vkar9898/Multi-Cluster-Control/gerbers/MCC_v1_bom.csv

Designator | Footprint | Quantity | Value | LCSC Part #
C1, C2 | CP_Radial_D10.0mm_P5.00mm | 2 | 470µF 25V
C10, C11, C14, C15, C5, C6, C7, C8, C9 | 0805 | 9 | 100nF | C49678
C16, C17 | 0805 | 2 | 1µF | C28323
C3, C4 | 0805 | 2 | 10µF 25V | C15850
CN1, CN2, CN3 | CONN-TH_10P-P3.81_WJ15EDGRH-3.81-10P-14-00A | 3 | WJ15EDGRH-3.81-10P-14-00A | C48336
CN4 | CONN-TH_4P-P3.81_WJ15EDGRH-3.81-4P-14-00A | 1 | WJ15EDGRH-3.81-4P-14-00A | C26231
D1, D2 | DO-201AD_BD5.3-L8.4-P12.50-D1.4-RD | 2 | SB560 | C139684
D11 | SMA_L4.2-W2.6-LS5.0-RD_1 | 1 | SS14 | C2480
D3, D4 | DO-15_BD3.1-L6.7-P10.70-D0.9-FD | 2 | P6KE15A | C10182
D5, D6, D7, D8, D9 | SOD-123F_L2.7-W1.6-LS3.8-RD | 5 | 1N4148W_C81598 | C81598
F1, F2 | FUSE-SMD_4P-L16.0-W6.7-P3.40 | 2 | 3568 | C5249699
J1, J2 | DC-IN-TH_DC-005-5A-2.0 | 2 | DC-005-5A-2.0 | C381116
J10, J8 | PinHeader_1x02_P2.54mm_Vertical | 2 | Conn_01x02
J11 | DIP-28_W15.24mm_Socket | 1 | Conn_02x14_Counter_Clockwise
J14 | PinHeader_1x03_P2.54mm_Vertical | 1 | Conn_01x03
J15 | TerminalBlock_Phoenix_MKDS-1,5-5-5.08_1x05_P5.08mm_Horizontal | 1 | Screw_Terminal_01x05
J3, J4 | PinSocket_1x19_P2.54mm_Vertical | 2 | Conn_01x19
J5 | PinHeader_1x06_P2.54mm_Vertical | 1 | Conn_01x06
J6 | PinHeader_1x05_P2.54mm_Vertical | 1 | Conn_01x05
J7, J9 | PinHeader_1x07_P2.54mm_Vertical | 2 | Conn_01x07
M5 | PinHeader_1x04_P2.54mm_Vertical | 1 | 5V
M6 | PinHeader_1x04_P2.54mm_Vertical | 1 | 3V6
M7 | PinHeader_1x04_P2.54mm_Vertical | 1 | 24V
Q1, Q2, Q3, Q4, Q5, Q6 | SOT-23-3_L2.9-W1.3-P1.90-LS2.4-BR | 6 | SS8050_C2150 | C2150
Q10, Q11, Q12, Q7, Q8, Q9 | SOT-23-3_L2.9-W1.3-P1.90-LS2.4-BR | 6 | SS8550_C8542 | C8542
Q15, Q16 | SOT-23-3_L2.9-W1.3-P1.90-LS2.4-BR | 2 | MMBT3904-C20526 | C20526
R1, R15, R2, R3, R4, R5, R6, R7, R8 | 0805 | 9 | 1k | C17513
R10, R11, R12, R13, R14, R16, R17, R18, R19, R20, R21, R9 | 0805 | 12 | 2.2k | C17520
R22, R23, R24, R25, R26, R27, R28, R29, R30, R31, R32, R33, R34, R35, R36, R37, R38 | 0805 | 17 | 10k | C17414
U1, U2, U3, U4 | SOIC-20W_7.5x12.8mm_P1.27mm | 4 | TPIC6B595N | C7094
U6, U7, U8 | SOIC-14_3.9x8.7mm_P1.27mm | 3 | 74LS125 | C5962
