vkar9898/Multi-Cluster-Control/(list of files, cad)

Other CAD files:
CAD/Multi-Cluster-Control.step
CAD/Multi-Cluster-Control.FCStd
