vkar9898/Multi-Cluster-Control/images/assembly_side.png

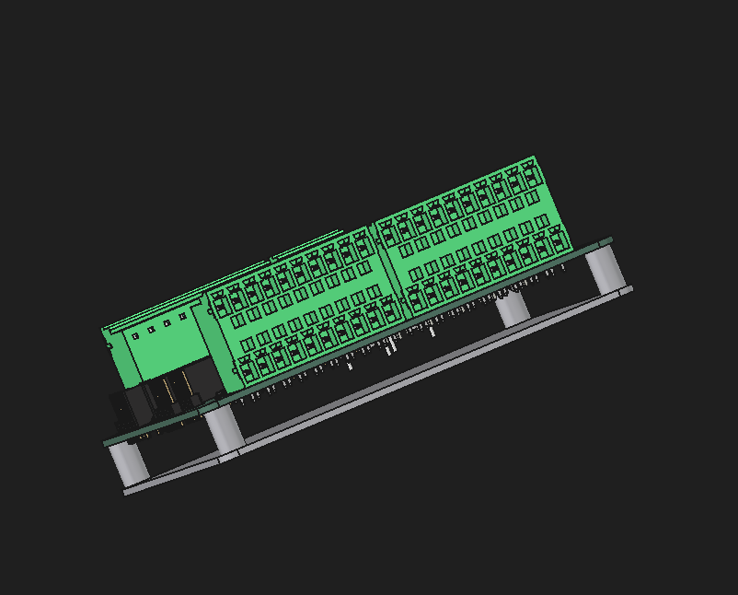
images/assembly_side.png
