vkar9898/Multi-Cluster-Control/images/assembly_top.png

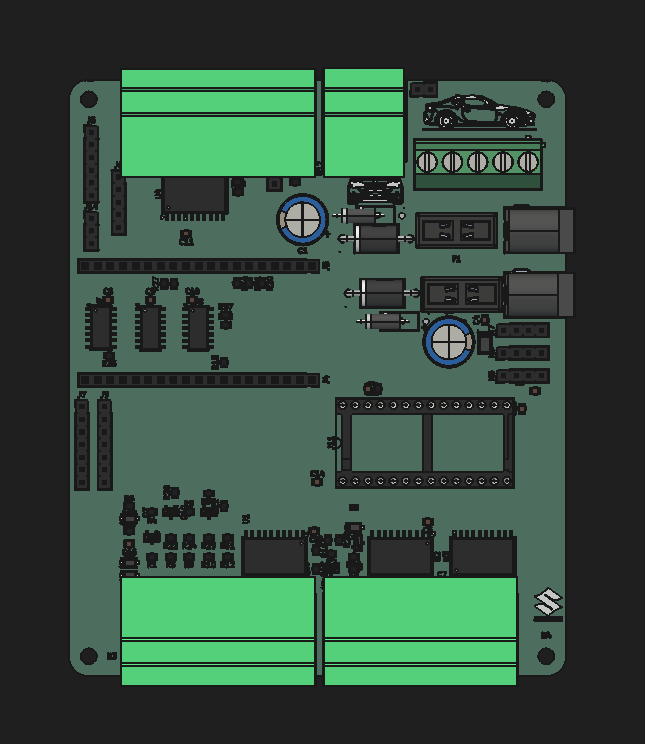
images/assembly_top.png
