vkar9898/Multi-Cluster-Control/JOURNAL.md

---
title: "Multi-Cluster-Control"
github: "https://github.com/vkar9898/Multi-Cluster-Control"
description: "One PCB that controls 7 real car instrument clusters independently, from 1980s analogue gauges requiring AC, to modern CAN-bus dashboards, all running independently from a single ESP32."
created_at: "2026-10-15"
total_time: "9h 36m"
---

# October 23, 2026: Began the schematic
<!-- fabricate:entry 1116 -->

Began making the schematic for the PCB. I plan where each dashboards wire goes before starting, and make the labels along the way. Did all the power stuff (Buck's, fuses, barrel jacks, and a booster). Also wired up the ESP32, as well as the level shifters, and the 4 shift registers. It's going great so far!



Timelapse: https://lapse.hackclub.com/timelapse/IOb_KaSfofoG

**Total time spent: 1h 30m**

# October 26, 2026: Finished the schematic.
<!-- fabricate:entry 1286 -->

Finished making the schematic. Added connector footprints for the 2 CAN modules, the X27 driver, and added all other essential PCB components (transistors, resistors, and capacitors), as well as some headers.



Timelapse: https://lapse.hackclub.com/timelapse/0e1cLzEHD6jz

**Total time spent: 1h**

# October 26, 2026 (entry 2): Started making the PCB
<!-- fabricate:entry 1293 -->

Started routing the PCB. It's a bit difficult due to there being many resistors, diodes, capacitors and such on almost every wire connected to the clusters, but hopefully I can make it all work. So far I haven't started tracing, to ensure fatal mistakes don't get locked in.



Timelapse: https://lapse.hackclub.com/timelapse/egfRrYyQpmj3

**Total time spent: 1h 6m**

# October 27, 2026: Continued placing and routing on PCB
<!-- fabricate:entry 1335 -->

Continued placing and routing on the PCB. Finished connector 1, and the majority of the power stuff. Decided to make the bottom layer a ground pour, which'll ease my life significantly for GND connections. So far it looks a bit cluttered, but there really isn't a much better way of doing it without relying quite heavily on vias.



Timelapse: https://lapse.hackclub.com/timelapse/pn_k8kwHLIcg

**Total time spent: 1h 30m**

# October 28, 2026: More PCB routing
<!-- fabricate:entry 1480 -->

Continued routing the PCB, as usual. Started the CN2 connector a fixed up some tracing issues with CN1 (things like not enough clearance, duplicate vias and such).



Timelapse: https://lapse.hackclub.com/timelapse/eUwztKtLVqtG

**Total time spent: 30m**

# October 29, 2026: Almost finished with the PCB
<!-- fabricate:entry 1528 -->

Almost finished with the PCB. Finished off CN2, and did the bulk of CN3, while ensuring that all lines get proper power with a thick enough trace. This was a little bit of a challenge on CN2, but I managed to make it work via the long route along the right of the PCB. It's starting to come together now, and I am becoming increasingly happier as I notice that there are less components to place.



Timelapse: https://lapse.hackclub.com/timelapse/g2Dk5GwVGELh

**Total time spent: 1h 30m**

# October 30, 2026: Finished the PCB
<!-- fabricate:entry 1643 -->

Finally completed the PCB in a long 2.5 hour session. Did CN3, CN4, and the U6-8 modules sitting underneath the ESP32, making sure no traces sit under the antenna. Also added some cool art of the W126 front, Suzuki logo (car is too niche to have any royalty free blueprints), GT86, and the F10. It looks great! The hardest part of this is definitely grounding everything, there were so many islands left that needed grounds...



Timelapse: https://lapse.hackclub.com/timelapse/QanxuUaG0hgY

**Total time spent: 2h 30m**
