vkar9898/Multi-Cluster-Control/KiCAD/Multi-Cluster-Control.kicad_pcb

## KiCad design KiCAD/Multi-Cluster-Control.kicad_pcb (2026-11-02)

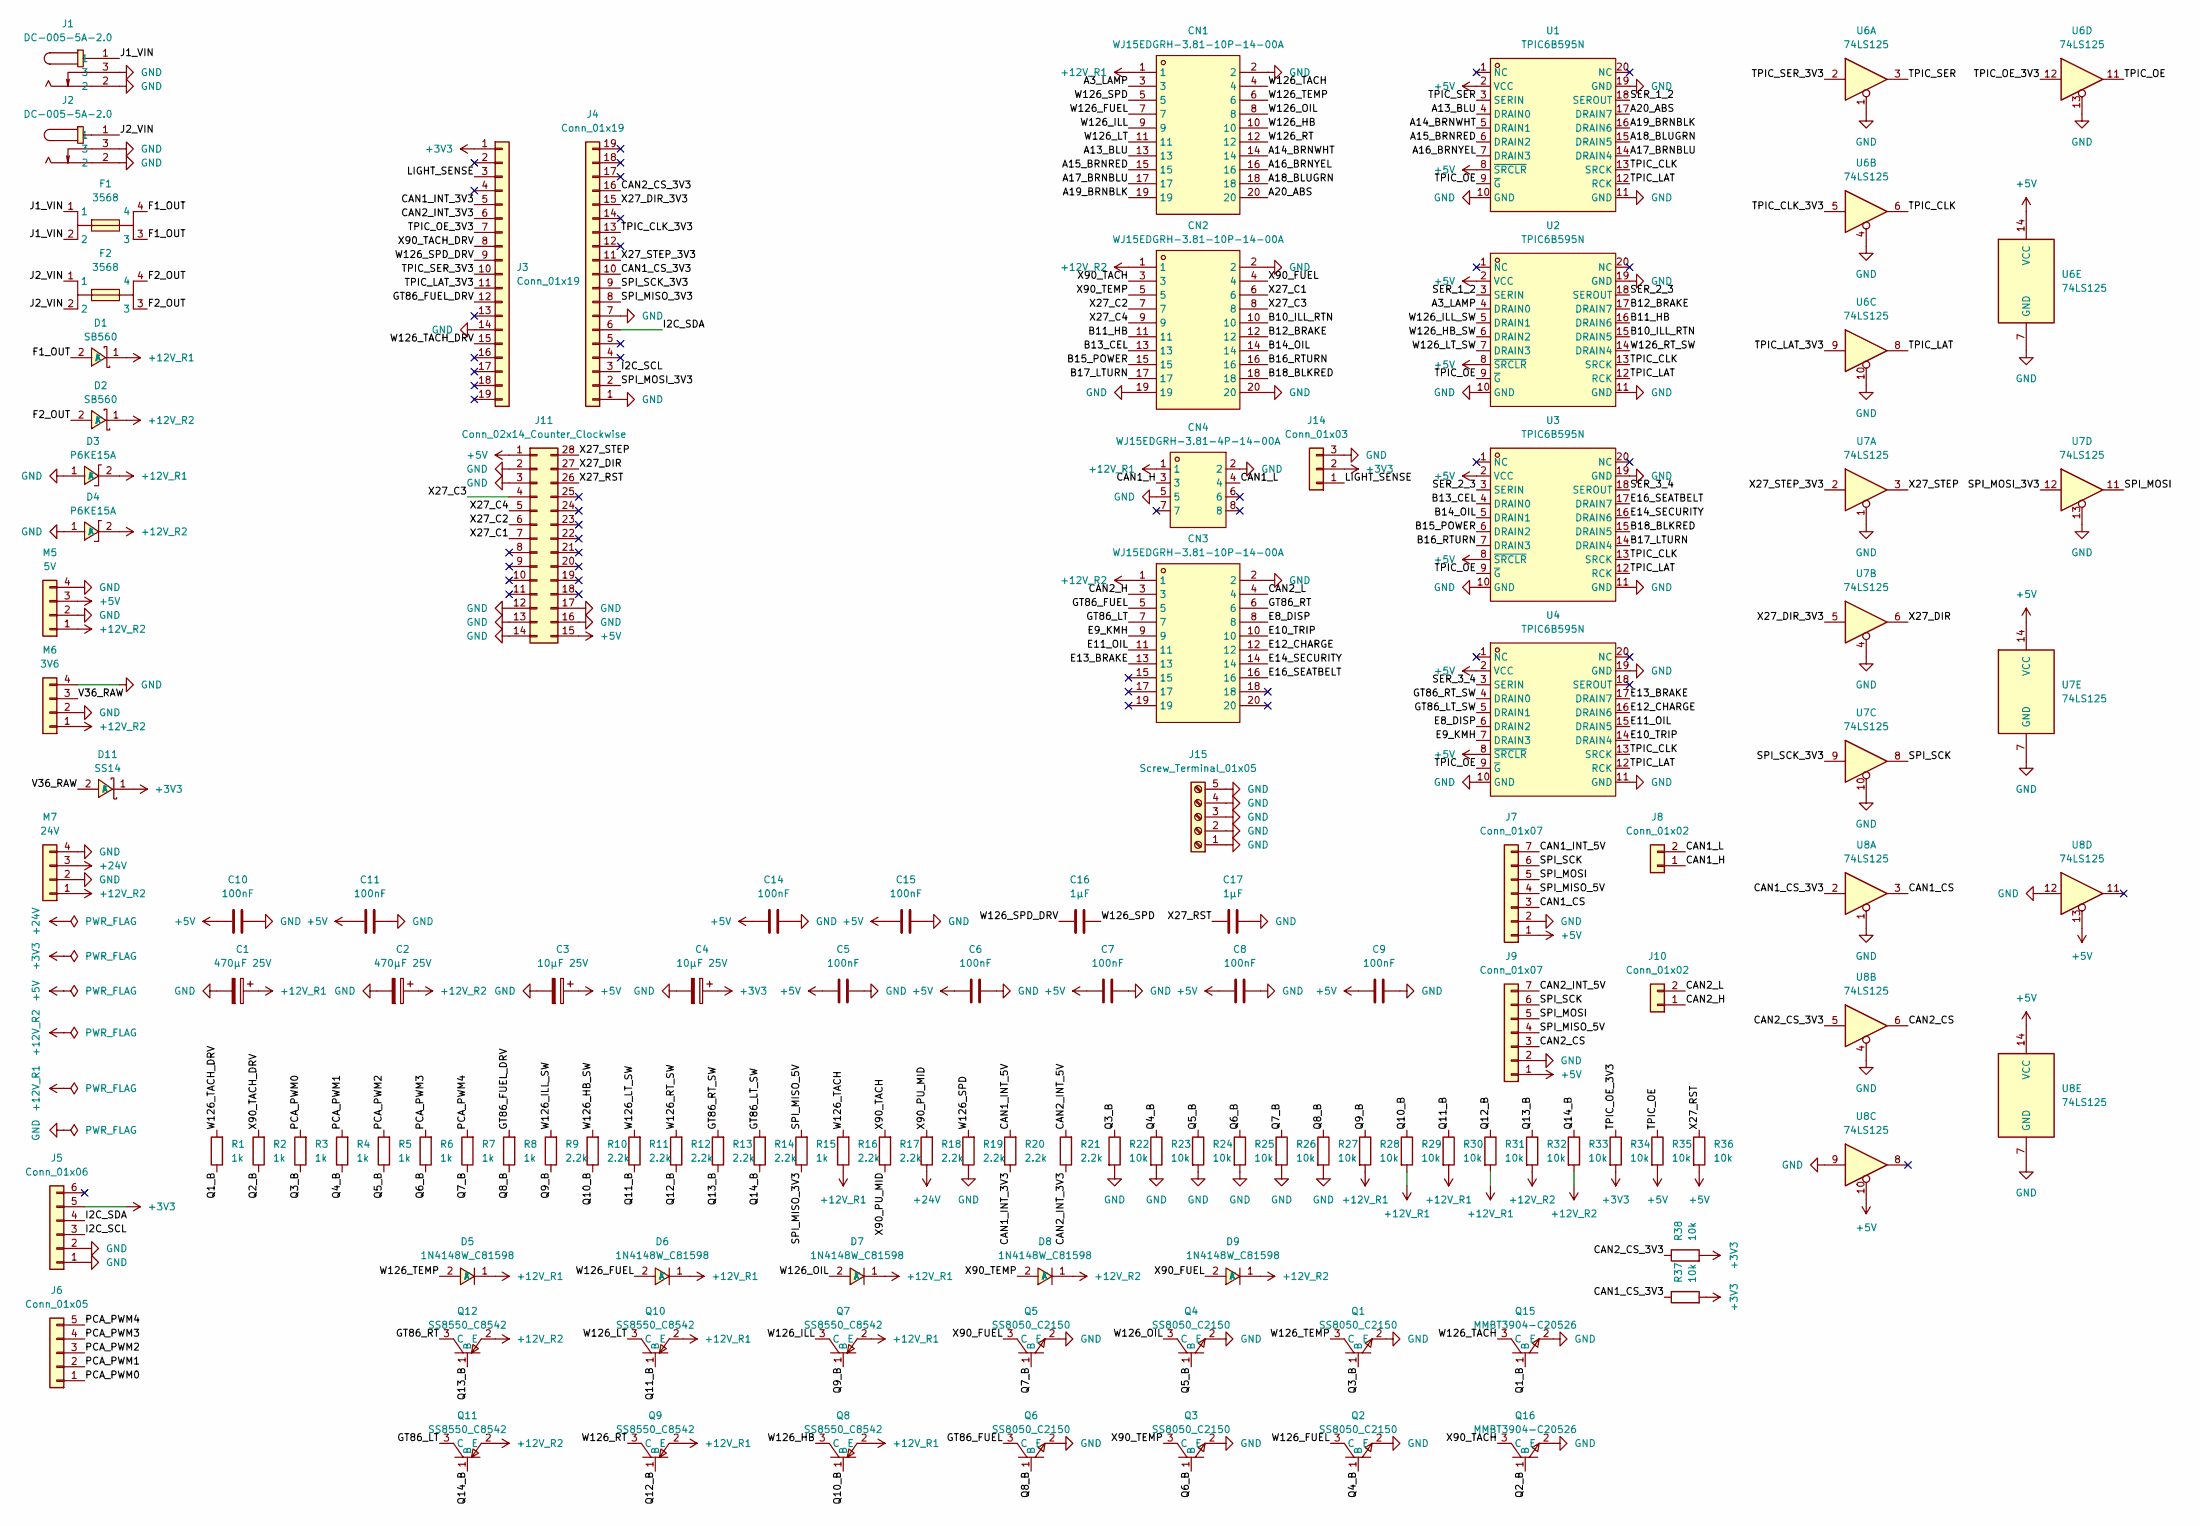
[picture p6: schematic Multi-Cluster-Control.kicad_sch]

Parts:
C1, C2: 470µF 25V; CP_Radial_D10.0mm_P5.00mm
C3, C4: 10µF 25V; C_0805_2012Metric; LCSC Part C15850
C5, C6, C7, C8, C9, C10, C11, C14, C15: 100nF; C_0805_2012Metric; LCSC Part C49678
C16, C17: 1µF; C_0805_2012Metric; LCSC Part C28323
CN1, CN2, CN3: WJ15EDGRH-3.81-10P-14-00A; CONN-TH_10P-P3.81_WJ15EDGRH-3.81-10P-14-00A; MPN WJ15EDGRH-3.81-10P-14-00A; LCSC Part C48336
CN4: WJ15EDGRH-3.81-4P-14-00A; CONN-TH_4P-P3.81_WJ15EDGRH-3.81-4P-14-00A; MPN WJ15EDGRH-3.81-04P-14-00A; LCSC Part C26231
D1, D2: SB560; DO-201AD_BD5.3-L8.4-P12.50-D1.4-RD; MPN SB560; LCSC Part C139684
D3, D4: P6KE15A; DO-15_BD3.1-L6.7-P10.70-D0.9-FD; MPN P6KE15A; LCSC Part C10182
D5, D6, D7, D8, D9: 1N4148W_C81598; SOD-123F_L2.7-W1.6-LS3.8-RD; MPN 1N4148W; LCSC Part C81598
D11: SS14; SMA_L4.2-W2.6-LS5.0-RD_1; MPN SS14; LCSC Part C2480
F1, F2: 3568; FUSE-SMD_4P-L16.0-W6.7-P3.40; MPN 3568; LCSC Part C5249699
J1, J2: DC-005-5A-2.0; DC-IN-TH_DC-005-5A-2.0; MPN DC-005-5A-2.0; LCSC Part C381116
J3, J4: Conn_01x19; PinSocket_1x19_P2.54mm_Vertical
J5: Conn_01x06; PinHeader_1x06_P2.54mm_Vertical
J6: Conn_01x05; PinHeader_1x05_P2.54mm_Vertical
J7, J9: Conn_01x07; PinHeader_1x07_P2.54mm_Vertical
J8, J10: Conn_01x02; PinHeader_1x02_P2.54mm_Vertical
J11: Conn_02x14_Counter_Clockwise; DIP-28_W15.24mm_Socket
J14: Conn_01x03; PinHeader_1x03_P2.54mm_Vertical
J15: Screw_Terminal_01x05; TerminalBlock_Phoenix_MKDS-1,5-5-5.08_1x05_P5.08mm_Horizont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
M5: 5V; PinHeader_1x04_P2.54mm_Vertical
M6: 3V6; PinHeader_1x04_P2.54mm_Vertical
M7: 24V; PinHeader_1x04_P2.54mm_Vertical
Q1, Q2, Q3, Q4, Q5, Q6: SS8050_C2150; SOT-23-3_L2.9-W1.3-P1.90-LS2.4-BR; MPN SS8050(RANGE:200-350); LCSC Part C2150
Q7, Q8, Q9, Q10, Q11, Q12: SS8550_C8542; SOT-23-3_L2.9-W1.3-P1.90-LS2.4-BR; MPN SS8550 Y2(RANGE:200-350); LCSC Part C8542
Q15, Q16: MMBT3904-C20526; SOT-23-3_L2.9-W1.3-P1.90-LS2.4-BR; MPN MMBT3904(RANGE:100-300); LCSC Part C20526
R1, R2, R3, R4, R5, R6, R7, R8, R15: 1k; R_0805_2012Metric; LCSC Part C17513
R9, R10, R11, R12, R13, R14, R16, R17, R18, R19, R20, R21: 2.2k; R_0805_2012Metric; LCSC Part C17520
R22, R23, R24, R25, R26, R27, R28, R29, R30, R31, R32, R33, R34, R35, R36, R37, R38: 10k; R_0805_2012Metric; LCSC Part C17414
U1, U2, U3, U4: TPIC6B595N; SOIC-20W_7.5x12.8mm_P1.27mm; MPN TPIC6B595N; LCSC Part C7094
U6, U7, U8: 74LS125; SOIC-14_3.9x8.7mm_P1.27mm; LCSC Part C5962

Connections:
+3V3: C4.1, D11.1 (K), J3.1, J5.5, J14.2, R34.2, R37.2, R38.2
+5V: C3.1, C5.2, C6.2, C7.2, C8.2, C9.2, C10.2, C11.2, C14.2, C15.2, J7.1, J9.1, J11.1, J11.15, M5.3, R35.2, R36.2, U1.2 (VCC), U1.8 (~SRCLR), U2.2 (VCC), U2.8 (~SRCLR), U3.2 (VCC), U3.8 (~SRCLR), U4.2 (VCC), U4.8 (~SRCLR), U6.14 (VCC), U7.14 (VCC), U8.10, U8.13, U8.14 (VCC)
+12V_R1: C1.1, CN1.1, CN4.1, D1.1 (K), D3.2 (K), D5.1 (K), D6.1 (K), D7.1 (K), Q7.2 (E), Q8.2 (E), Q9.2 (E), Q10.2 (E), R16.1, R28.2, R29.2, R30.2, R31.2
+12V_R2: C2.1, CN2.1, CN3.1, D2.1 (K), D4.2 (K), D8.1 (K), D9.1 (K), M5.1, M6.1, M7.1, Q11.2 (E), Q12.2 (E), R32.2, R33.2
+24V: M7.3, R18.1
/A3_LAMP: CN1.3, U2.4 (DRAIN0)
/A13_BLU: CN1.13, U1.4 (DRAIN0)
/A14_BRNWHT: CN1.14, U1.5 (DRAIN1)
/A15_BRNRED: CN1.15, U1.6 (DRAIN2)
/A16_BRNYEL: CN1.16, U1.7 (DRAIN3)
/A17_BRNBLU: CN1.17, U1.14 (DRAIN4)
/A18_BLUGRN: CN1.18, U1.15 (DRAIN5)
/A19_BRNBLK: CN1.19, U1.16 (DRAIN6)
/A20_ABS: CN1.20, U1.17 (DRAIN7)
/B10_ILL_RTN: CN2.10, U2.15 (DRAIN5)
/B11_HB: CN2.11, U2.16 (DRAIN6)
/B12_BRAKE: CN2.12, U2.17 (DRAIN7)
/B13_CEL: CN2.13, U3.4 (DRAIN0)
/B14_OIL: CN2.14, U3.5 (DRAIN1)
/B15_POWER: CN2.15, U3.6 (DRAIN2)
/B16_RTURN: CN2.16, U3.7 (DRAIN3)
/B17_LTURN: CN2.17, U3.14 (DRAIN4)
/B18_BLKRED: CN2.18, U3.15 (DRAIN5)
/CAN1_CS: J7.3, U8.3
/CAN1_CS_3V3: J4.10, R37.1, U8.2
/CAN1_H: CN4.3, J8.1
/CAN1_INT_3V3: J3.5, R20.1
/CAN1_INT_5V: J7.7, R20.2
/CAN1_L: CN4.4, J8.2
/CAN2_CS: J9.3, U8.6
/CAN2_CS_3V3: J4.16, R38.1, U8.5
/CAN2_H: CN3.3, J10.1
/CAN2_INT_3V3: J3.6, R21.1
/CAN2_INT_5V: J9.7, R21.2
/CAN2_L: CN3.4, J10.2
/E8_DISP: CN3.8, U4.6 (DRAIN2)
/E9_KMH: CN3.9, U4.7 (DRAIN3)
/E10_TRIP: CN3.10, U4.14 (DRAIN4)
/E11_OIL: CN3.11, U4.15 (DRAIN5)
/E12_CHARGE: CN3.12, U4.16 (DRAIN6)
/E13_BRAKE: CN3.13, U4.17 (DRAIN7)
/E14_SECURITY: CN3.14, U3.16 (DRAIN6)
/E16_SEATBELT: CN3.16, U3.17 (DRAIN7)
/F1_OUT: D1.2 (A), F1.3, F1.4
/F2_OUT: D2.2 (A), F2.3, F2.4
/GT86_FUEL: CN3.5, Q6.3 (C)
/GT86_FUEL_DRV: J3.12, R8.2
/GT86_LT: CN3.7, Q11.3 (C)
/GT86_LT_SW: R14.2, U4.5 (DRAIN1)
/GT86_RT: CN3.6, Q12.3 (C)
/GT86_RT_SW: R13.2, U4.4 (DRAIN0)
/I2C_SCL: J4.3, J5.3
/I2C_SDA: J4.6, J5.4
/J1_VIN: F1.1, F1.2, J1.1
/J2_VIN: F2.1, F2.2, J2.1
/LIGHT_SENSE: J3.3, J14.1
/PCA_PWM0: J6.1, R3.2
/PCA_PWM1: J6.2, R4.2
/PCA_PWM2: J6.3, R5.2
/PCA_PWM3: J6.4, R6.2
/PCA_PWM4: J6.5, R7.2
/Q1_B: Q15.1 (B), R1.1
/Q2_B: Q16.1 (B), R2.1
/Q3_B: Q1.1 (B), R3.1, R22.1
/Q4_B: Q2.1 (B), R4.1, R23.1
/Q5_B: Q4.1 (B), R5.1, R24.1
/Q6_B: Q3.1 (B), R6.1, R25.1
/Q7_B: Q5.1 (B), R7.1, R26.1
/Q8_B: Q6.1 (B), R8.1, R27.1
/Q9_B: Q7.1 (B), R9.1, R28.1
/Q10_B: Q8.1 (B), R10.1, R29.1
/Q11_B: Q10.1 (B), R11.1, R30.1
/Q12_B: Q9.1 (B), R12.1, R31.1
/Q13_B: Q12.1 (B), R13.1, R32.1
/Q14_B: Q11.1 (B), R14.1, R33.1
/SER_1_2: U1.18 (SEROUT), U2.3 (SERIN)
/SER_2_3: U2.18 (SEROUT), U3.3 (SERIN)
/SER_3_4: U3.18 (SEROUT), U4.3 (SERIN)
/SPI_MISO_3V3: J4.8, R15.1
/SPI_MISO_5V: J7.4, J9.4, R15.2
/SPI_MOSI: J7.5, J9.5, U7.11
/SPI_MOSI_3V3: J4.2, U7.12
/SPI_SCK: J7.6, J9.6, U7.8
/SPI_SCK_3V3: J4.9, U7.9
/TPIC_CLK: U1.13 (SRCK), U2.13 (SRCK), U3.13 (SRCK), U4.13 (SRCK), U6.6
/TPIC_CLK_3V3: J4.13, U6.5
/TPIC_LAT: U1.12 (RCK), U2.12 (RCK), U3.12 (RCK), U4.12 (RCK), U6.8
/TPIC_LAT_3V3: J3.11, U6.9
/TPIC_OE: R35.1, U1.9 (~G), U2.9 (~G), U3.9 (~G), U4.9 (~G), U6.11
/TPIC_OE_3V3: J3.7, R34.1, U6.12
/TPIC_SER: U1.3 (SERIN), U6.3
/TPIC_SER_3V3: J3.10, U6.2
/V36_RAW: D11.2 (A), M6.3
/W126_FUEL: CN1.7, D6.2 (A), Q2.3 (C)
/W126_HB: CN1.10, Q8.3 (C)
/W126_HB_SW: R10.2, U2.6 (DRAIN2)
/W126_ILL: CN1.9, Q7.3 (C)
/W126_ILL_SW: R9.2, U2.5 (DRAIN1)
/W126_LT: CN1.11, Q10.3 (C)
/W126_LT_SW: R11.2, U2.7 (DRAIN3)
/W126_OIL: CN1.8, D7.2 (A), Q4.3 (C)
/W126_RT: CN1.12, Q9.3 (C)
/W126_RT_SW: R12.2, U2.14 (DRAIN4)
/W126_SPD: C16.1, CN1.5, R19.2
/W126_SPD_DRV: C16.2, J3.9
/W126_TACH: CN1.4, Q15.3 (C), R16.2
/W126_TACH_DRV: J3.15, R1.2
/W126_TEMP: CN1.6, D5.2 (A), Q1.3 (C)
/X27_C1: CN2.6, J11.7
/X27_C2: CN2.7, J11.6
/X27_C3: CN2.8, J11.4
/X27_C4: CN2.9, J11.5
/X27_DIR: J11.27, U7.6
/X27_DIR_3V3: J4.15, U7.5
/X27_RST: C17.2, J11.26, R36.1
/X27_STEP: J11.28, U7.3
/X27_STEP_3V3: J4.11, U7.2
/X90_FUEL: CN2.4, D9.2 (A), Q5.3 (C)
/X90_PU_MID: R17.1, R18.2
/X90_TACH: CN2.3, Q16.3 (C), R17.2
/X90_TACH_DRV: J3.8, R2.2
/X90_TEMP: CN2.5, D8.2 (A), Q3.3 (C)
GND: C1.2, C2.2, C3.2, C4.2, C5.1, C6.1, C7.1, C8.1, C9.1, C10.1, C11.1, C14.1, C15.1, C17.1, CN1.2, CN2.2, CN2.19, CN2.20, CN3.2, CN4.2, CN4.5, D3.1 (A), D4.1 (A), J1.2, J1.3, J2.2, J2.3, J3.14, J4.1, J4.7, J5.1, J5.2, J7.2, J9.2, J11.2, J11.3, J11.12, J11.13, J11.14, J11.16, J11.17, J14.3, J15.1, J15.2, J15.3, J15.4, J15.5, M5.2, M5.4, M6.2, M6.4, M7.2, M7.4, Q1.2 (E), Q2.2 (E), Q3.2 (E), Q4.2 (E), Q5.2 (E), Q6.2 (E), Q15.2 (E), Q16.2 (E), R19.1, R22.2, R23.2, R24.2, R25.2, R26.2, R27.2, U1.10 (GND), U1.11 (GND), U1.19 (GND), U2.10 (GND), U2.11 (GND), U2.19 (GND), U3.10 (GND), U3.11 (GND), U3.19 (GND), U4.10 (GND), U4.11 (GND), U4.19 (GND), U6.1, U6.4, U6.7 (GND), U6.10, U6.13, U7.1, U7.4, U7.7 (GND), U7.10, U7.13, U8.1, U8.4, U8.7 (GND), U8.9, U8.12

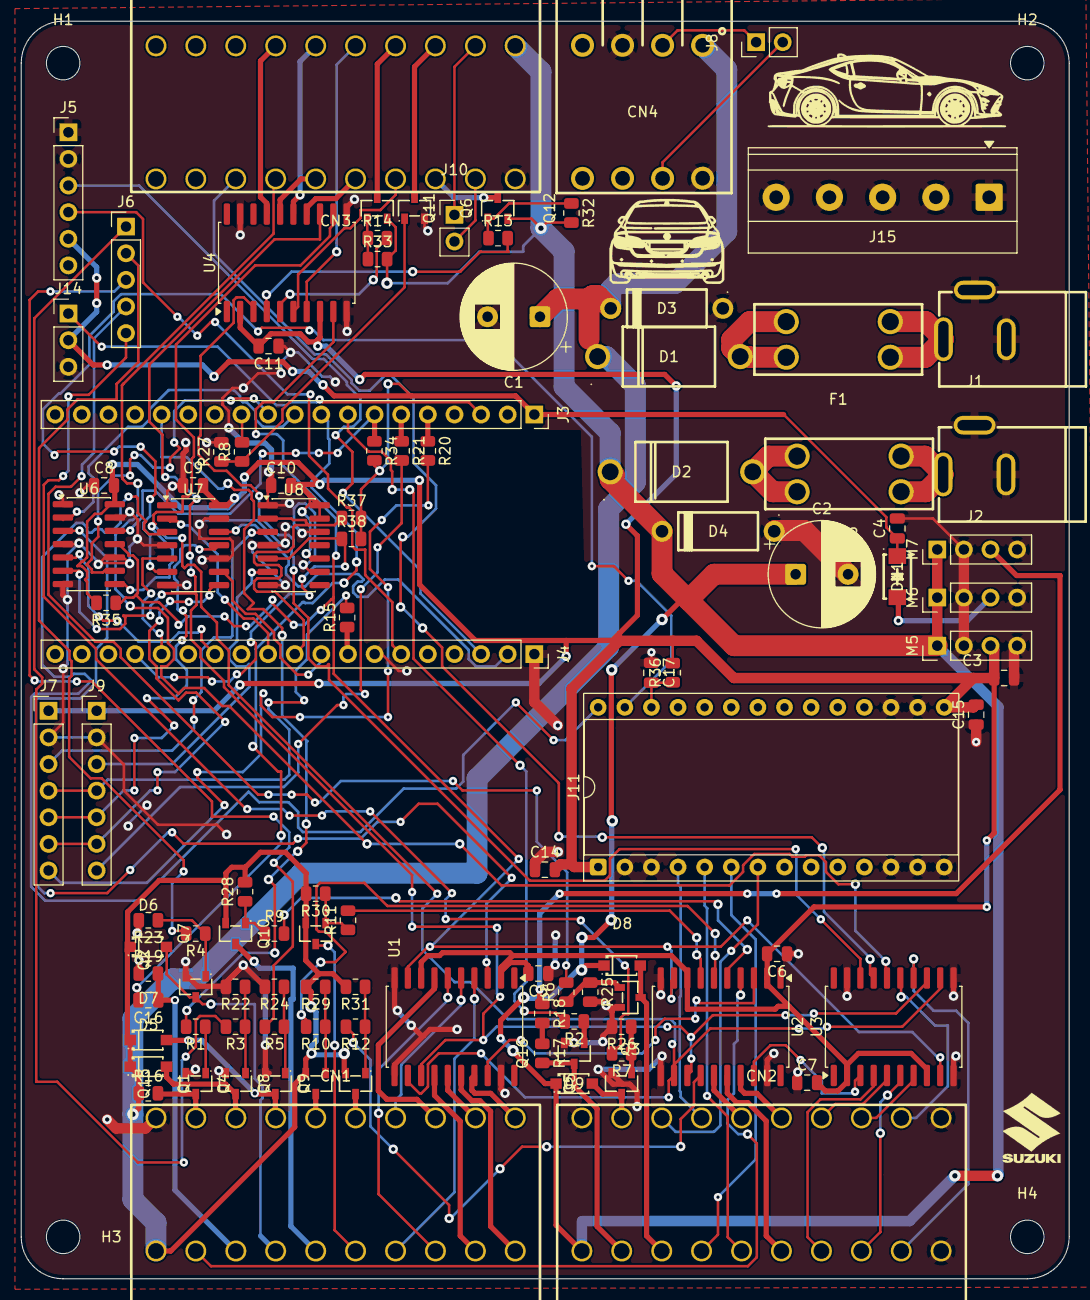
[picture p7: board Multi-Cluster-Control.kicad_pcb from above]

Board: 2 copper layers, 100.0 x 120.0 mm, 110 parts (0 on the bottom side), 123 nets.

Other parts of the board:
H1, H2, H3, H4: MountingHole_3.2mm_M3
