vkar9898/Multi-Cluster-Control/Wiring/sensor-extension-cable.yml

# Sensor cable — edit any property or use the visual inspector.
metadata:
  title: Sensor extension cable
  description: Four conductors between a sensor and its controller.

connectors:
  W126:
    type: Cluster
    subtype: female
    pincount: 23
    pinlabels:
      - BLK/PNK X4
      - PNK/BLK X2
      - RED/WHT
      - BLK/RED
      - BRN X3
      - BRN/GRY (ext)
      - GRN/YEL
      - WHT ( 8 pin)
      - GRN
      - BLU/BLK
      - BRN/GRN
      - GRY/BLU (8 pin)
      - WHT (15 pin)
      - BLK/WHT
      - BLK/GRN
      - BLU
      - BRN/WHT
      - BRN/RED
      - BRN/YEL
      - BRN/BLU
      - BLU/GRN
      - BRN/BLK
      - BRN/YEL (ext)
  CN1:
    type: JST XH
    subtype: male
    pincount: 20
    pinlabels:
      - +12V
      - GND
      - Bulb Failure
      - Tach
      - Speedo
      - Temp Gauge
      - Fuel Gauge
      - Oil Pressure Gauge
      - Illumination
      - High Beam
      - Left Turn
      - Right Turn
      - Battery
      - Brake fluid
      - Pad wear
      - Coolant level
      - Washer fluid
      - Fuel reserve
      - Oil level
      - ABS
  X-90:
    type: Cluster
    pincount: 23
    pinlabels:
      - BLK/WHT X2
      - BLK X2
      - WHT/BLU
      - BLK/YEL
      - BRN/WHT
      - YEL/RED
      - YEL/WHT
      - X27 Pin 1
      - X27 Pin 2
      - X27 Pin 3
      - X27 Pin 4
      - RED/YEL
      - RED
      - RED/BLK
      - PNK/YEL
      - YEL/BLK
      - PNK
      - GRN/YEL
      - GRN/RED
      - WHT/RED
      - WHT/BLK
      - GRY/RED
      - ORG/BLK
  CN2:
    type: Connector
    pincount: 20
    pinlabels:
      - +12V
      - GND
      - Tach
      - Fuel Gauge
      - Temp Gauge
      - X27 Pin 1
      - X27 Pin 2
      - X27 Pin 3
      - X27 Pin 4
      - Illumination return
      - High Beam
      - Brake
      - Check engine
      - Oil pressure
      - Power
      - Right turn
      - Left turn
      - " "
  CN3 (X90 Lamps):
    type: Connector
    pincount: 2
    pinlabels:
      - Seatbelt
      - 4WD
  GT86:
    type: Connector
    pincount: 18
    pinlabels:
      - RED/WHT
      - WHT/GRN X2
      - BLK/YEL X2
      - BLU
      - BRN
      - BRN/WHT
      - LGN
      - GRY
      - WHT/RED
      - PNK
      - LGN thick
      - GRN
      - WHT/BLU
      - VIO
      - RED/BLK
  CN3:
    type: Connector
    pincount: 18
    pinlabels:
      - +12V
      - GND
      - CAN-H
      - CAN-L
      - Fuel sender
      - Right turn
      - Left turn
      - TRIP
      - Oil
      - Charge
      - Brake
      - Security
      - Seatbelt
  F10:
    type: Connector
    pincount: 8
    pinlabels:
      - Pin 1
      - Pin 2
      - Pin 11
      - Pin 7
      - Pin 8
      - Pin 6
      - Pin 12
  CN4:
    type: Connector
    pincount: 8
    pinlabels:
      - +12V
      - GND
      - CAN-H
      - CAN-L

cables:
  20 core cable:
    wirecount: 20
    gauge: 20 AWG
    length: 0.5
    colors: [ RD, BK, YE, GN ]
    wirelabels:
      - ""
      - ""
      - ""
      - ""
  W1:
    wirecount: 20
    color_code: IEC
    gauge: 20 AWG
    length: 0.5
  W2:
    wirecount: 2
    color_code: IEC
    gauge: 20 AWG
    length: 0.5
  W3:
    wirecount: 18
    color_code: IEC
    gauge: 20 AWG
    length: 0.5
  W4:
    wirecount: 8
    color_code: IEC
    gauge: 220 AWG
    length: 0.5

connections:
  - - W126:
        - 1
    - 20 core cable:
        - 1
    - CN1:
        - 1
  - - 20 core cable: 5
    - CN1: 5
  - - 20 core cable: 6
    - CN1: 6
  - - 20 core cable: 7
    - CN1: 7
  - - 20 core cable: 8
    - CN1: 8
  - - 20 core cable: 9
    - CN1: 9
  - - 20 core cable: 10
    - CN1: 10
  - - 20 core cable: 12
    - CN1: 12
  - - 20 core cable: 11
    - CN1: 11
  - - 20 core cable: 13
    - CN1: 13
  - - 20 core cable: 14
    - CN1: 14
  - - 20 core cable: 15
    - CN1: 15
  - - 20 core cable: 16
    - CN1: 16
  - - 20 core cable: 17
    - CN1: 17
  - - 20 core cable: 19
    - CN1: 19
  - - 20 core cable: 20
    - CN1: 20
  - - 20 core cable: 18
    - CN1: 18
  - - W126: 4
    - 20 core cable: 1
  - - W126: 3
    - 20 core cable: 1
  - - W126: 2
    - 20 core cable: 1
  - - W126: 5
    - 20 core cable: 2
  - - 20 core cable: 2
    - CN1: 2
  - - W126: 6
    - 20 core cable: 3
  - - 20 core cable: 3
    - CN1: 3
  - - 20 core cable: 4
    - CN1: 4
  - - W126: 7
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
  - - W4
  - - CN4
  - - F10: 1
    - W4: 1
  - - W4: 1
    - CN4: 1
  - - F10: 2
    - W4: 1
  - - F10: 3
    - W4: 1
  - - F10: 4
    - W4: 2
  - - F10: 5
    - W4: 2
  - - W4: 2
    - CN4: 2
  - - W4: 3
    - CN4: 3
  - - W4: 4
    - CN4: 4
  - - F10: 7
    - W4: 4
  - - F10: 6
    - W4: 3
