vkar9898/Multi-Cluster-Control/(commit log)

2026-10-31 Create Wiring
2026-10-31 Update and rename sensor-extension-cable.yml to Wiring
2026-11-01 Revise BOM with updated parts and shipping costs
    Updated BOM with new pricing and item details.
    [bom.csv]
2026-11-01 Add BOM section to README
    Added a Bill of Materials (BOM) section detailing components, suppliers, and costs for the project.
2026-11-02 Removed placeholders, added gerbers and .STEP assembly.
    [MCC_v1_bom.csv, MCC_v1_designators.csv, MCC_v1_positions.csv, Multi-Cluster-Control.step]
2026-11-10 Update BOM with new and modified entries
    [bom.csv]
